thaumatichthys/srd-pulse-test/step-recovery-pulser.kicad_pcb

## KiCad design step-recovery-pulser.kicad_pcb (2026-11-08)

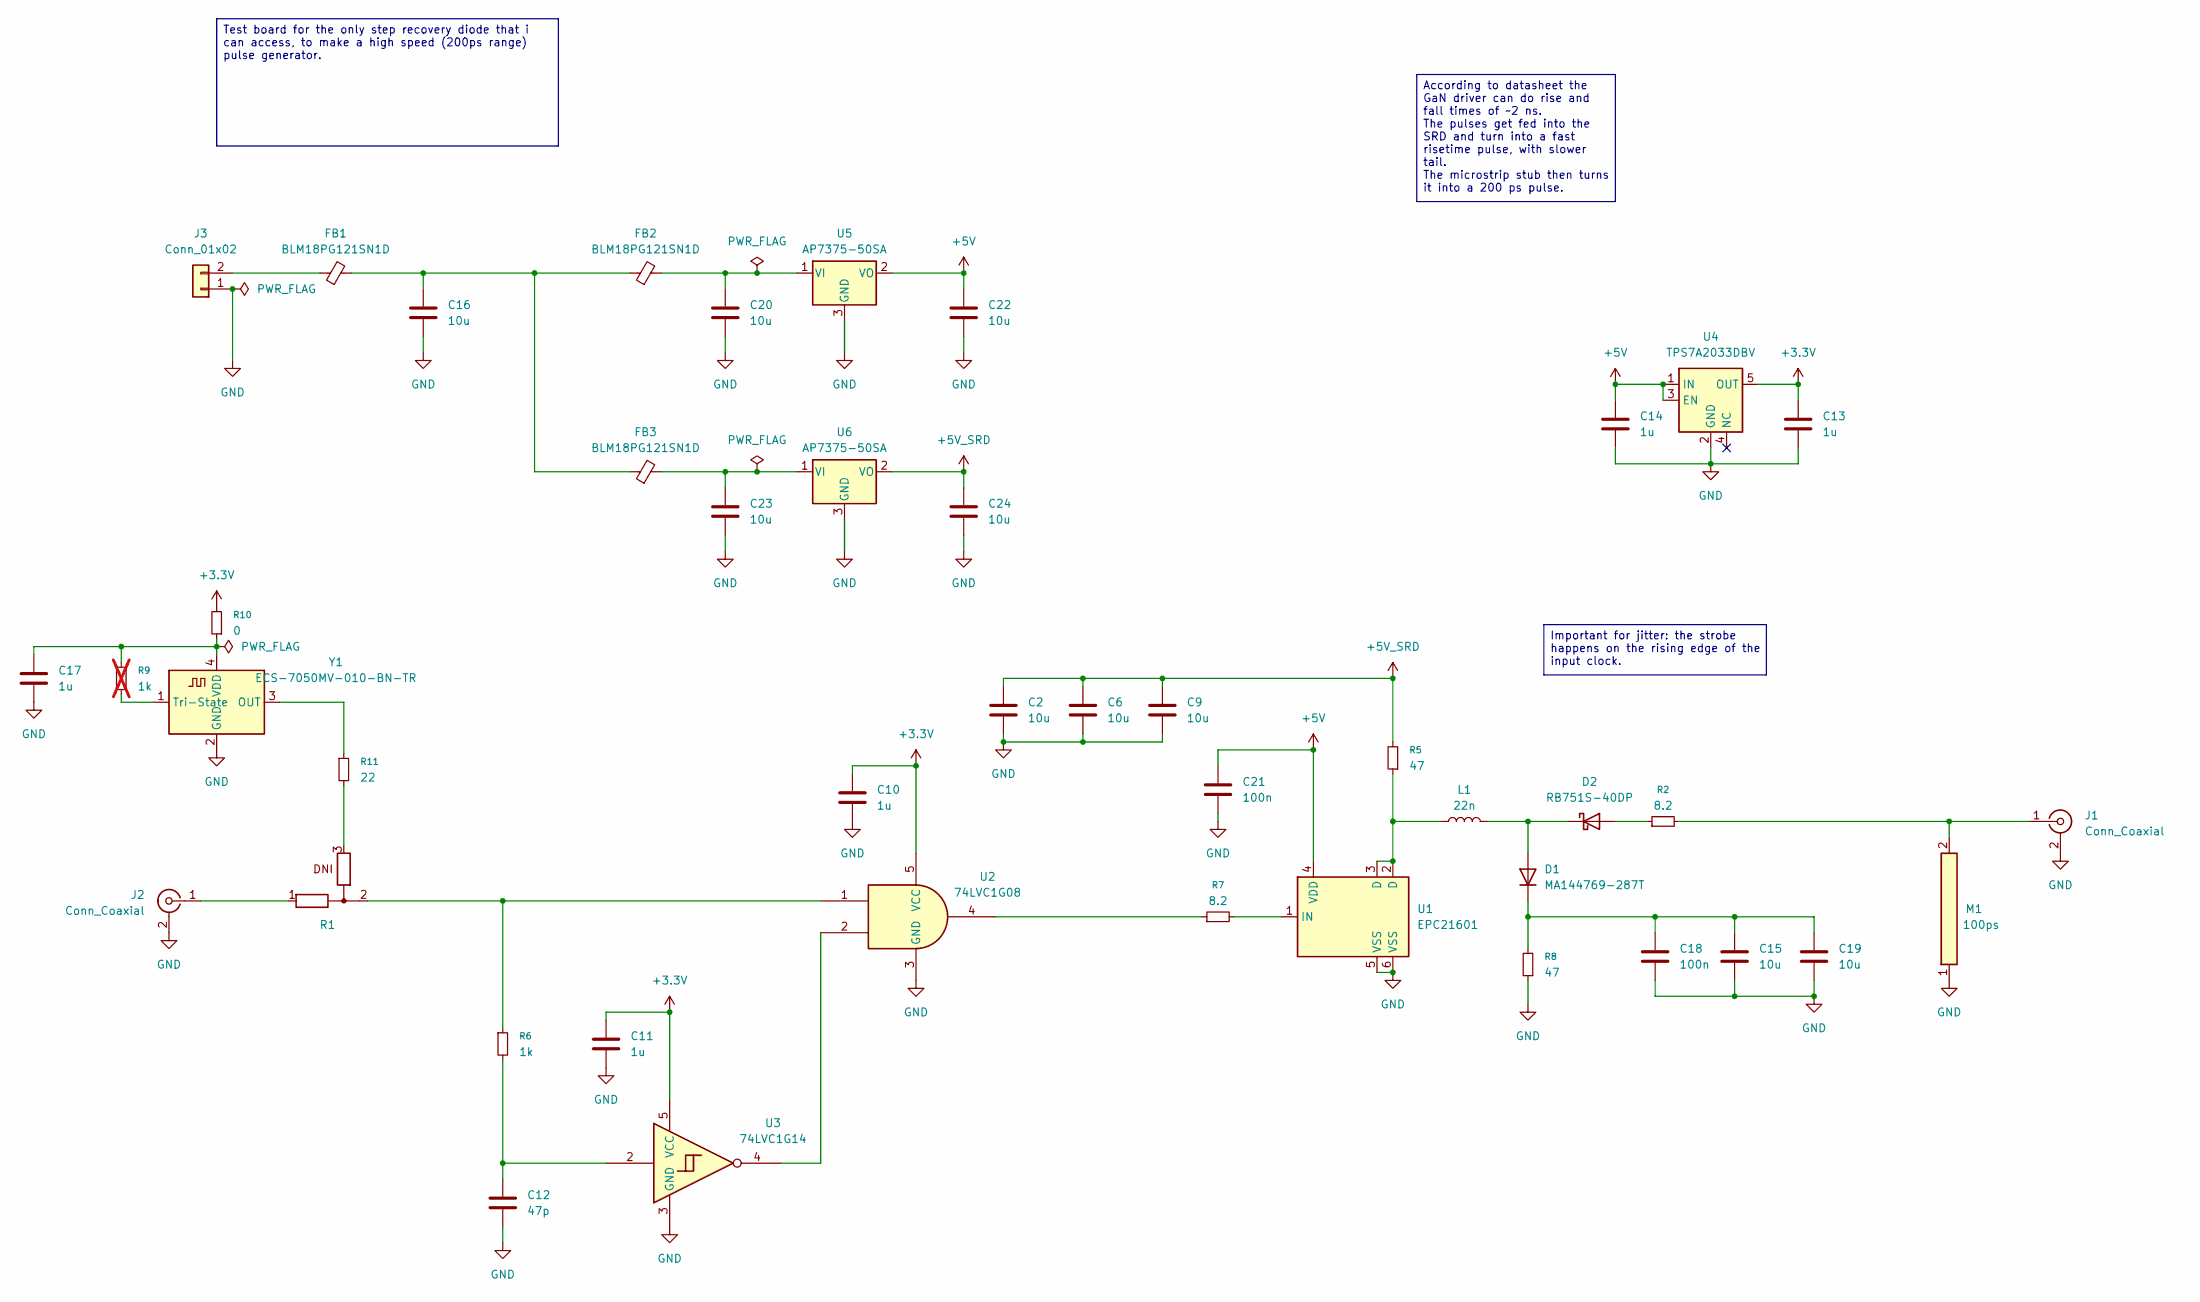
[picture p1: schematic step-recovery-pulser.kicad_sch]

Parts:
C2, C6, C9, C15, C16, C19, C20, C22, C23, C24: 10u; C_0805_2012Metric
C10, C11, C13, C14, C17: 1u; C_0402_1005Metric
C12: 47p; C_0402_1005Metric
C18, C21: 100n; C_0201_0603Metric
D1: MA144769-287T; SOT-23
D2: RB751S-40DP; D_0201_0603Metric
FB1, FB2, FB3: BLM18PG121SN1D; L_0603_1608Metric
J1, J2: Conn_Coaxial; ADAMTECH_RF2-143-T-17-50-G_IMPROVED
J3: Conn_01x02; PinHeader_1x02_P2.54mm_Vertical
L1: 22n; L_0402_1005Metric
M1: 100ps; MICROSTRIP_L17_W0.35
R1: R_0402_SELECT_MIRRORED
R2, R7: 8.2; R_0201_0603Metric
R5, R8: 47; R_0805_2012Metric
R6: 1k; R_0402_1005Metric
R9: 1k; R_0402_1005Metric; not fitted
R10: 0; R_0402_1005Metric
R11: 22; R_0402_1005Metric
U1: EPC21601; EPC_BGA-6_P0.5
U2: 74LVC1G08; SOT-353_SC-70-5
U3: 74LVC1G14; SOT-353_SC-70-5
U4: TPS7A2033DBV; SOT-23-5
U5, U6: AP7375-50SA; SOT-23
Y1: ECS-7050MV-010-BN-TR; Oscillator_SMD_IQD_IQXO70-4Pin_7.5x5.0mm_HandSoldering

Connections:
+3.3V: C10.1, C11.1, C13.1, R10.2, U2.5 (VCC), U3.5 (VCC), U4.5 (OUT)
+5V: C14.1, C21.1, C22.2, U1.4 (VDD), U4.1 (IN), U4.3 (EN), U5.2 (VO)
+5V_SRD: C2.2, C6.2, C9.2, C24.2, R5.2, U6.2 (VO)
GND: C2.1, C6.1, C9.1, C10.2, C11.2, C12.1, C13.2, C14.2, C15.1, C16.1, C17.2, C18.2, C19.1, C20.1, C21.2, C22.1, C23.1, C24.1, J1.2 (Ext), J2.2 (Ext), J3.1, M1.1, R8.1, U1.5 (VSS), U1.6 (VSS), U2.3 (GND), U3.3 (GND), U4.2 (GND), U5.3 (GND), U6.3 (GND), Y1.2 (GND)
unnamed: C12.2, R6.2, U3.2
unnamed: C16.2, FB1.2, FB2.1, FB3.1
unnamed: D1.1 (A), D2.1 (K), L1.2
unnamed: C15.2, C18.1, C19.2, D1.3 (K), R8.2
unnamed: D2.2 (A), R2.1
unnamed: J1.1 (In), M1.2, R2.2
unnamed: J2.1 (In), R1.1
unnamed: FB1.1, J3.2
unnamed: L1.1, R5.1, U1.2 (D), U1.3 (D)
unnamed: R1.2, R6.1, U2.1
unnamed: R1.3, R11.2
unnamed: R7.1, U2.4
unnamed: R7.2, U1.1 (IN)
unnamed: U2.2, U3.4
unnamed: C20.2, FB2.2, U5.1 (VI)
unnamed: C23.2, FB3.2, U6.1 (VI)
unnamed: R11.1, Y1.3 (OUT)
unnamed: R9.2, Y1.1 (Tri-State)
unnamed: C17.1, R9.1, R10.1, Y1.4 (VDD)

Notes on the sheet:
Test board for the only step recovery diode that i can access, to make a high speed (200ps range) pulse generator.
According to datasheet the GaN driver can do rise and fall times of ~2 ns. The pulses get fed into the SRD and turn into a fast risetime pulse, with slower tail. The microstrip stub then turns it into a 200 ps pulse.
Important for jitter: the strobe happens on the rising edge of the input clock.

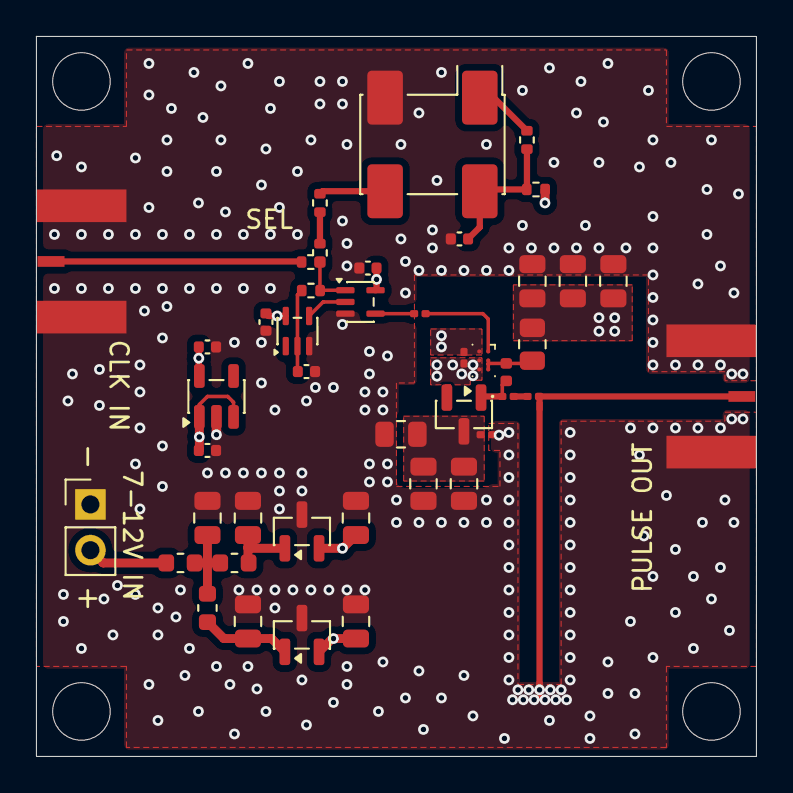
[picture p2: board step-recovery-pulser.kicad_pcb from above]

Board: 4 copper layers, 40.0 x 40.0 mm, 44 parts (0 on the bottom side), 23 nets.
