thaumatichthys/srd-pulse-test/(commit log)

2026-11-07 removed shunt reference, fixed misc stuff
    [step-recovery-pulser.kicad_sch]
2026-11-07 routed pcb
    [step-recovery-pulser.kicad_pcb, step-recovery-pulser.kicad_sch]
2026-11-07 improved layout slightly
    [step-recovery-pulser.kicad_pcb]
2026-11-08 likely order ready
    [step-recovery-pulser.kicad_pcb]
2026-11-08 Add README for Step Recovery Diode Pulse Generator
    Added initial documentation for the Step Recovery Diode Pulse Generator, including details on the SRD and its operation.
